Osama-Badran/ENG4000_Capstone_Low_Print_Solar_Tracking_System/Blender/FinalRender1.png

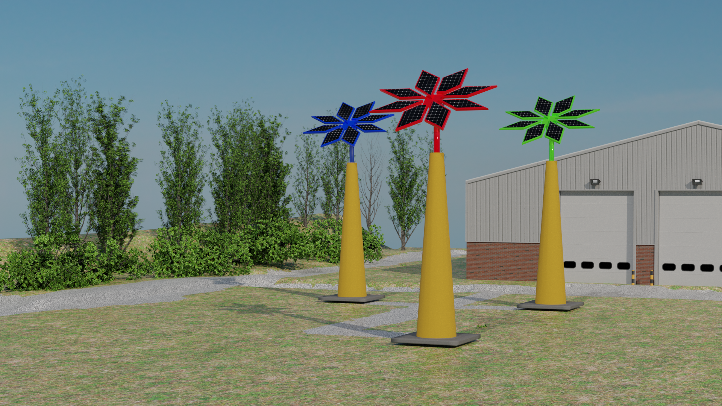
Blender/FinalRender1.png
