Osama-Badran/ENG4000_Capstone_Low_Print_Solar_Tracking_System/Code/README.md

# Code

Arduino C/C++ firmware for the solar tracking system.

- `ENG4000_ProjectCode` — main firmware: LDR polling, stepper motor control, angle clamping, and JSON telemetry output over serial.

Built for an Arduino Uno (AVR ATmega328P). Motor drivers, sensor wiring, and pin assignments are documented in the root README.
