Osama-Badran/ENG4000_Capstone_Low_Print_Solar_Tracking_System/Blender/README.md

# Blender

VR scene and render assets for the solar farm design.

- `*.blend` — scene files
- `renders/` — exported images
- `assets/` — free-use models and textures

The scene was built from CAD models and used for design validation and stakeholder presentations. Being able to walk through the site in VR made it easier to spot layout problems before committing to a physical build.
