Osama-Badran/ENG4000_Capstone_Low_Print_Solar_Tracking_System/ArcGIS/README.md

# ArcGIS

Geospatial analysis files used to optimize panel placement on the FEC site in Alberta.

- Site boundary and terrain data
- Panel placement analysis
- Land usage calculations

Files were used to evaluate placement options against output targets, with the goal of minimizing footprint while maintaining the required energy generation.
