Osama-Badran/ENG4000_Capstone_Low_Print_Solar_Tracking_System/Blender/360RenderVR.png

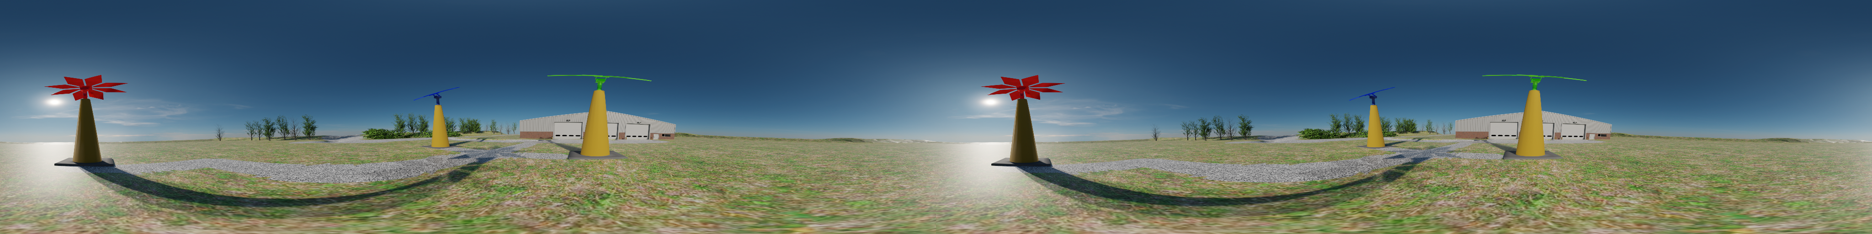
Blender/360RenderVR.png
