Osama-Badran/ENG4000_Capstone_Low_Print_Solar_Tracking_System/Blender/EarlyDraftRender1.png

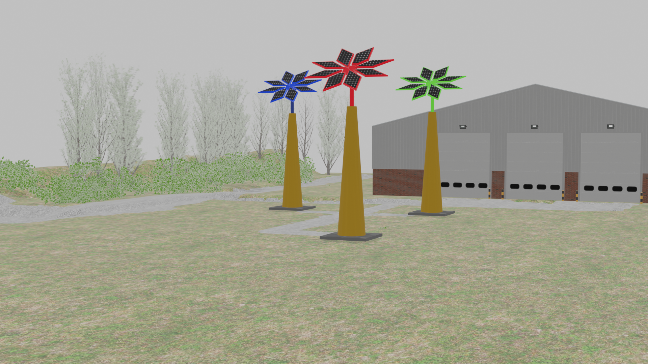
Blender/EarlyDraftRender1.png
