Osama-Badran/ENG4000_Capstone_Low_Print_Solar_Tracking_System/Blender/FinalRender2.png

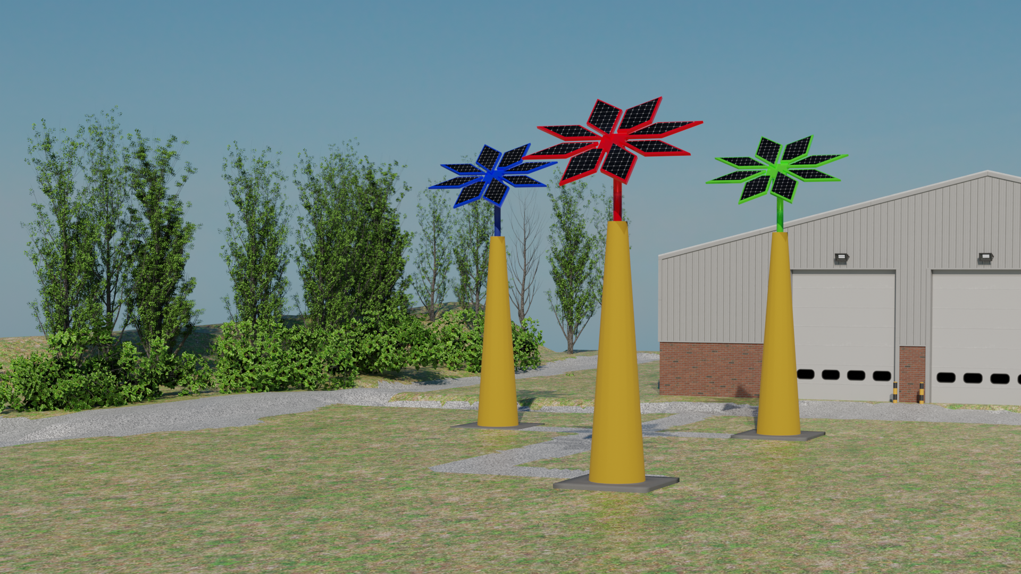
Blender/FinalRender2.png
