Osama-Badran/ENG4000_Capstone_Low_Print_Solar_Tracking_System/ArcGIS/WaterFeaturesLayout.pdf

## Foundation of the Energy Collective / La Fondation de l’Energie Located In Foothills County, AB

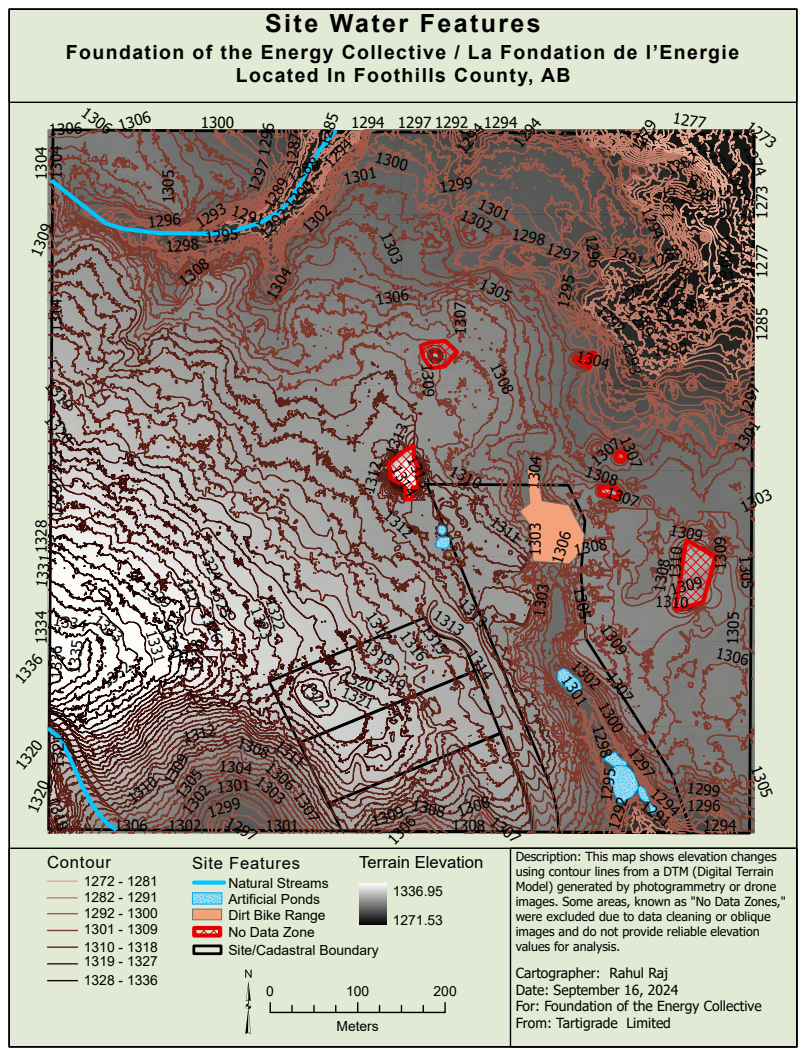
[picture p21: page 1]
Contour; Meters; Terrain Elevation; Site/Cadastral Boundary; values for analysis.

Site Water Features

Description: This map shows elevation changes
using contour lines from a DTM (Digital Terrain
Model) generated by photogrammetry or drone
images. Some areas, known as "No Data Zones,"
were excluded due to data cleaning or oblique
images and do not provide reliable elevation

Site Features
Natural Streams
Artificial Ponds
Dirt Bike Range
No Data Zone

Cartographer: Rahul Raj
Date: September 16, 2024
For: Foundation of the Energy Collective
From: Tartigrade Limited
